tanzim99901/hermes/Connections_gyroscope_arduino.JPG

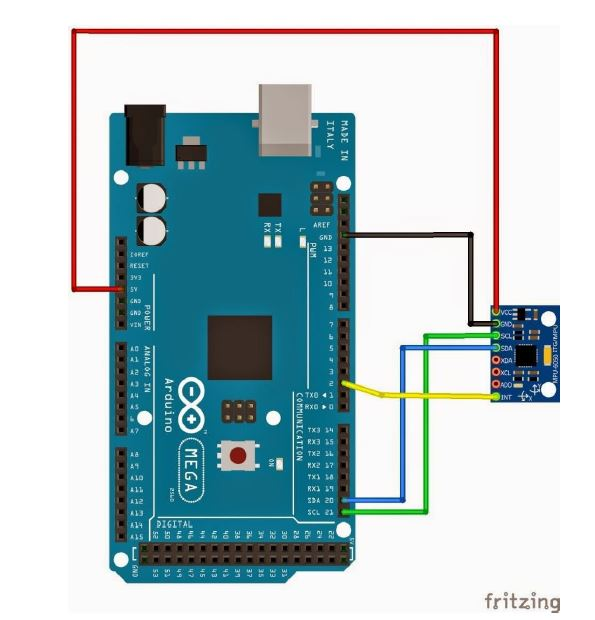
Connections_gyroscope_arduino.JPG
