tanzim99901/hermes/Lead_acid_battery_charger.JPG

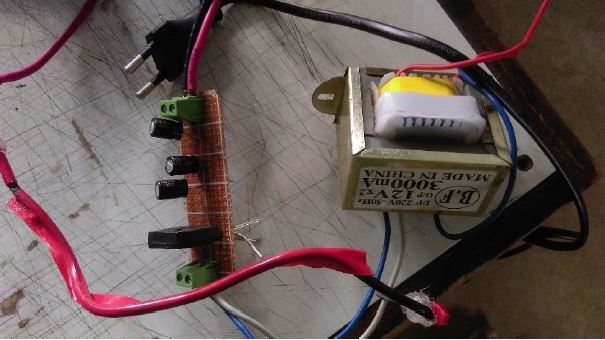
Lead_acid_battery_charger.JPG
