tanzim99901/hermes/Connections_motor_driver_arduino.JPG

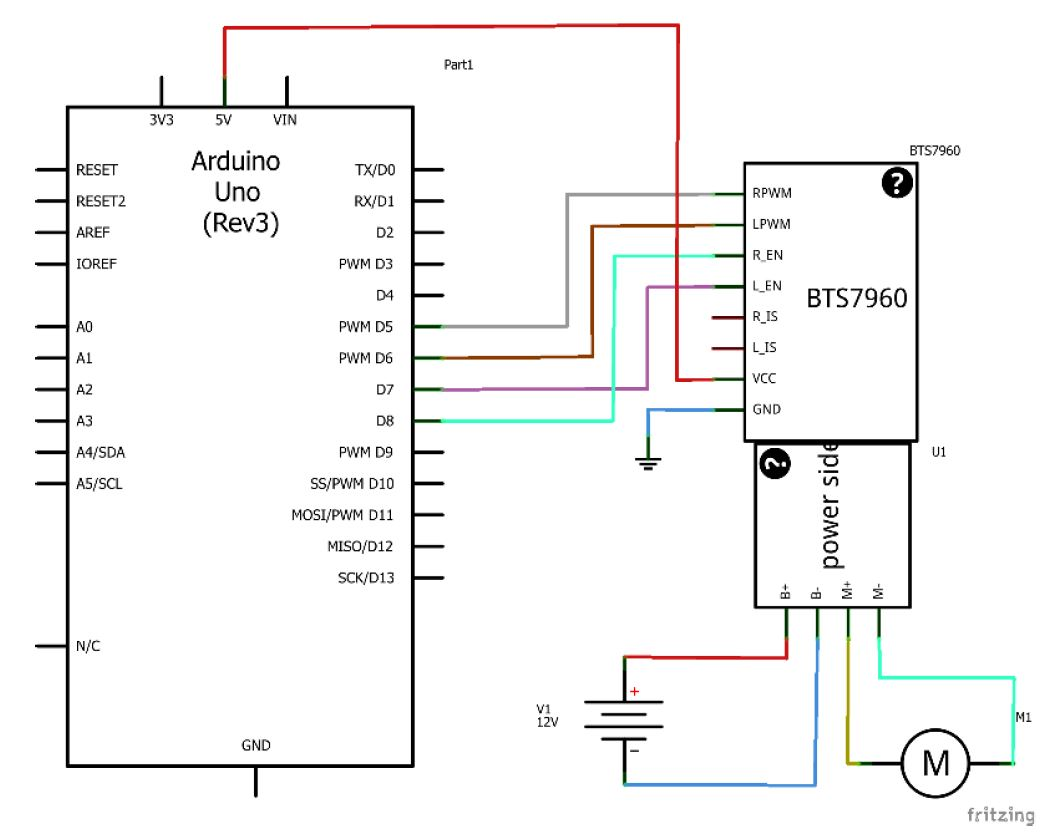
Connections_motor_driver_arduino.JPG
