tanzim99901/hermes/Hermes_1.jpg

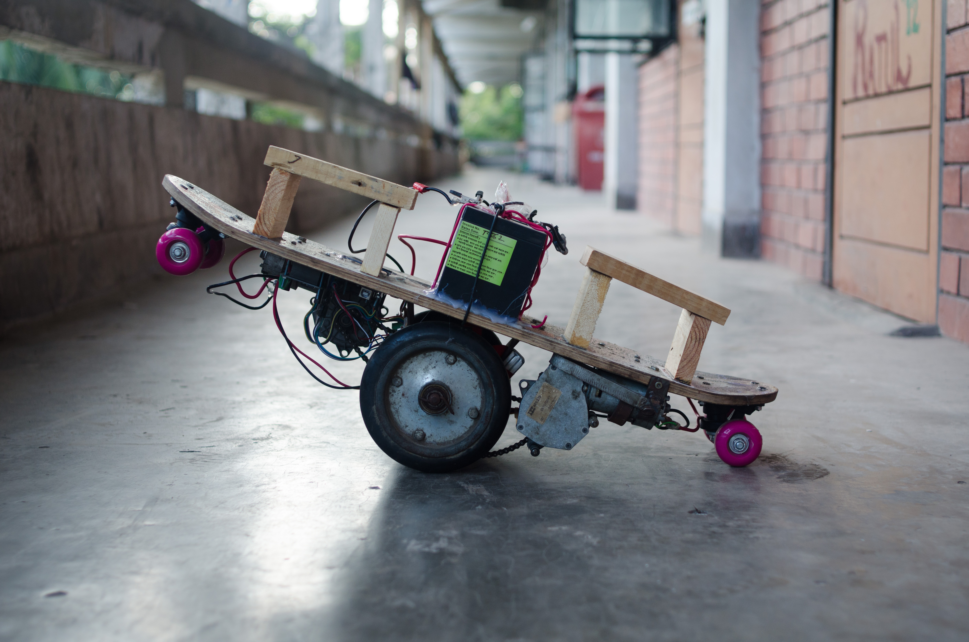
Hermes_1.jpg
