tanzim99901/hermes/Hermes_2.jpg

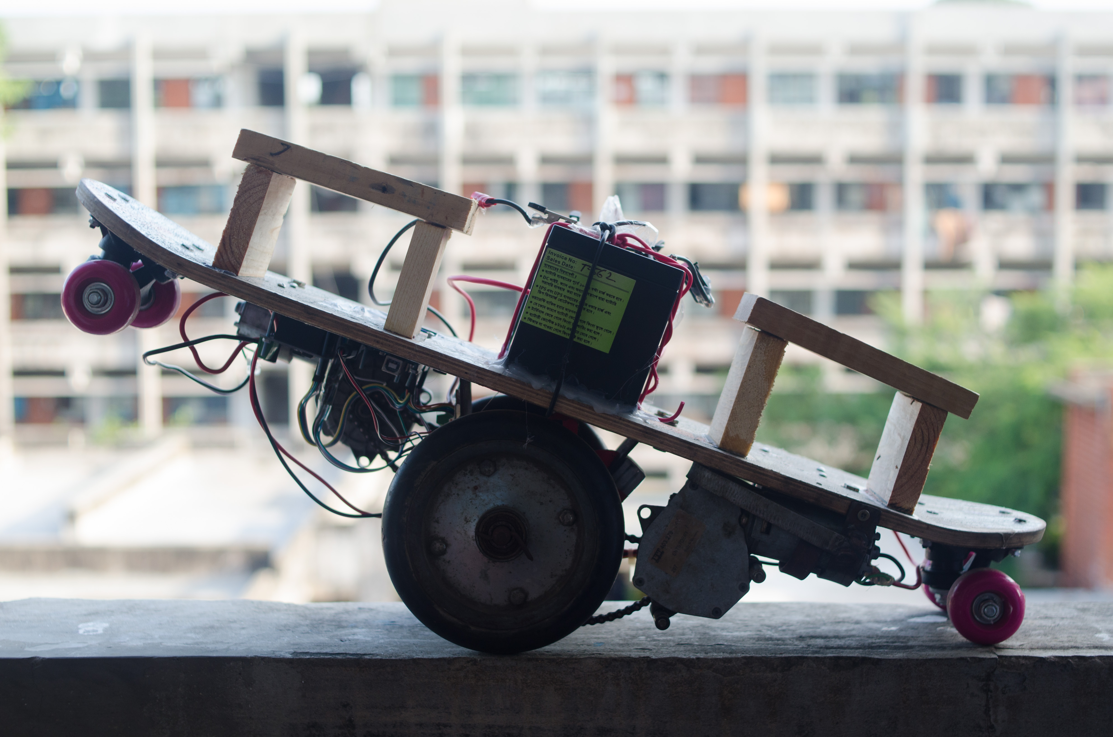
Hermes_2.jpg
