tanzim99901/hermes/Hermes_underside.jpg

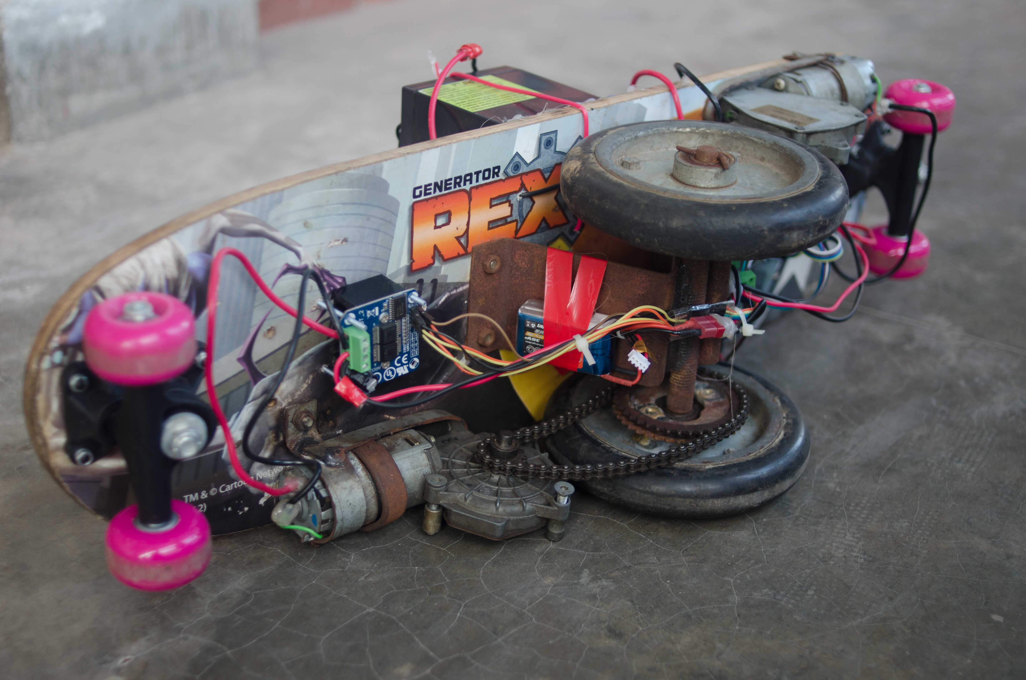
Hermes_underside.jpg
