tanzim99901/hermes/Lead_acid_battery_charger_reference.JPG

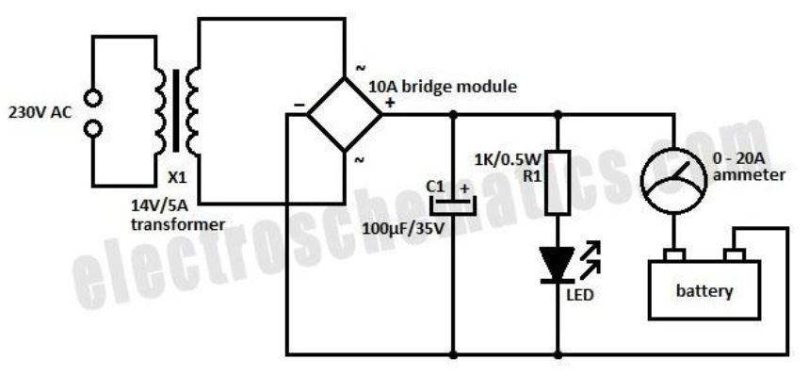
Lead_acid_battery_charger_reference.JPG
