tanzim99901/hermes/Structure_schematic.JPG

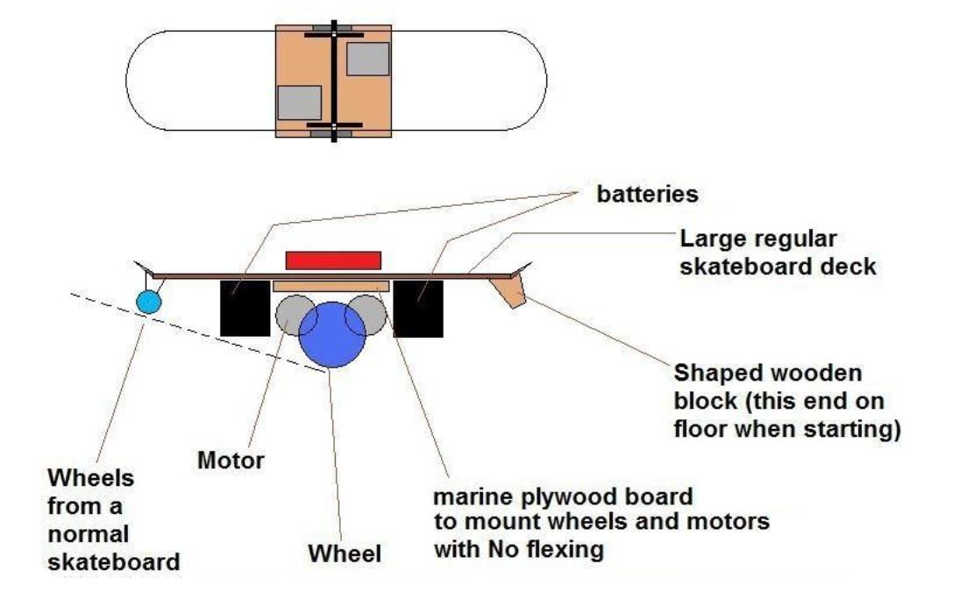
Structure_schematic.JPG
